aambrose3/ANTERO-Gripper/5B3D-Finger-Model/Circular vs Elliptical Contact Location Error.png

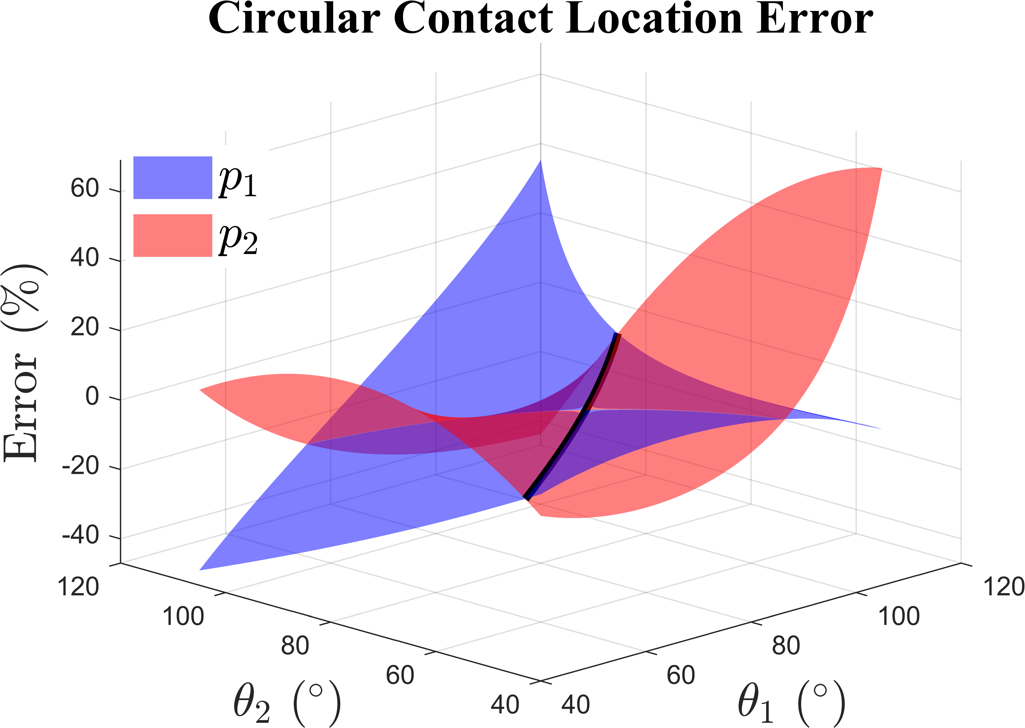
5B3D-Finger-Model/Circular vs Elliptical Contact Location Error.png
