aambrose3/ANTERO-Gripper/5B3D-Finger-Optimization/Feasible-Workspace-Example.png

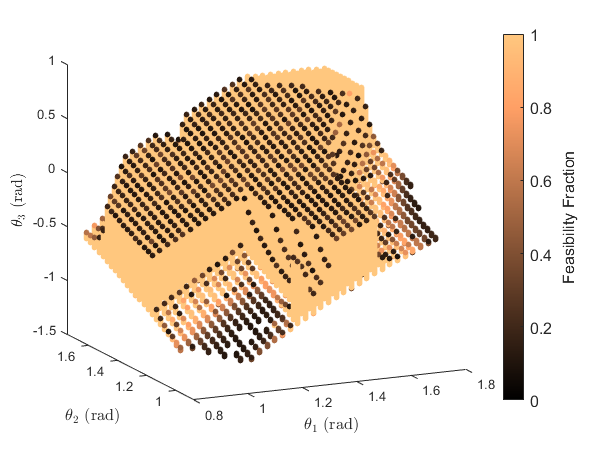
5B3D-Finger-Optimization/Feasible-Workspace-Example.png
