aambrose3/ANTERO-Gripper/5B3D-Spring-Optimization/Simulated_Spring_00236.png

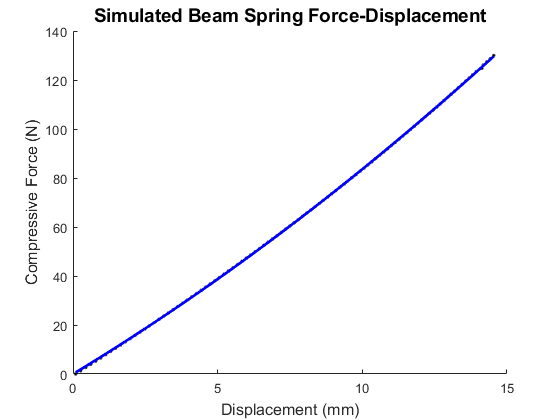
5B3D-Spring-Optimization/Simulated_Spring_00236.png
