aambrose3/ANTERO-Gripper/ANTERO-Mid-Level-Control/PCB Design Files/ANTERO-MidLevel-Control-BOM.pdf

Alex_Teensy4_PCB_BOM_FINAL

Item | Qty (Per Board minimum) | Hyperlink
10 uF Capacitor | | 1 10 uF Cap (https://www.digikey.com/short/b2b8575r)
74LVC2G241DP (3.3V Reg) | | 1 74LVC2G241DP (3.3V Reg) (https://www.digikey.com/short/0vnzmr8h)
AS11AH Switch | | 1 AS11AH Switch (https://mou.sr/4gSaKLc)
JST S3B-EH (Dynamixel Header) | | 1 JST S3B-EH (Dynamixel Header) (https://www.digikey.com/short/1n9ch75f)
LED | | 3 LED (https://www.digikey.com/short/578tjwhb)
Picoblade 1x2 Header | | 1 Picoblade 1x2 Header (https://mou.sr/4hxGuGB)
Picoblade 1x3 Header | | 1 Picoblade 1x3 Header (https://www.digikey.com/short/5mnzjcz0)
Picoblade 1x4 Header | | 2 Picoblade 1x4 Header (https://www.digikey.com/short/jjw4p01n)
Teensy 4.0 | | 1 Teensy 4.0 (https://www.digikey.com/short/fn4n75td)
TLV70233_SOT23-5 | | 1 TLV70233_SOT23-5 (https://www.digikey.com/short/dr4vqt0f)
TS 637 RA Button | | 1 TS 637 RA Button (https://www.digikey.com/short/wfrh9v0z)
TXB0108PWR | | 1 TXB0108PWR (https://www.digikey.com/short/48w32wwn)
Picoblade Wire Crimp | | 12 Picoblade Wire Crimp (https://www.digikey.com/short/d1z87z4w)
1x2 Picoblade Crimp Housing | | 1 1x2 Picoblade Crimp Housing (https://www.digikey.com/short/vjb89p32)
1x3 Picoblade Crimp Housing | | 1 1x3 Picoblade Crimp Housing (https://www.digikey.com/short/pr1hjfqf)
1x4 Picoblade Crimp Housing | | 2 1x4 Picoblade Crimp Housing (https://www.digikey.com/short/mfz52j53)
1x4 Picoblade Crimp Housing | 2
Total

Rec. Qty (5 Boards + Extra) Price Per Unit Price | Digikey/Mouser URLs
10 $1.22 | $12.18 | https://www.digikey.com/short/b2b8575r
10 $0.30 | $2.95 | https://www.digikey.com/short/0vnzmr8h
5 $5.09 | $25.45 | https://mou.sr/4gSaKLc
10 $0.12 | $1.17 | https://www.digikey.com/short/1n9ch75f
18 $0.21 | $3.83 | https://www.digikey.com/short/578tjwhb
10 $0.27 | $2.66 | https://mou.sr/4hxGuGB
10 $0.21 | $2.11 | https://www.digikey.com/short/5mnzjcz0
15 $0.30 | $4.52 | https://www.digikey.com/short/jjw4p01n
5 $27.60 | $138.00 | https://www.digikey.com/short/fn4n75td
10 $0.16 | $1.63 | https://www.digikey.com/short/dr4vqt0f
10 $0.58 | $5.82 | https://www.digikey.com/short/wfrh9v0z
10 $1.03 | $10.28 | https://www.digikey.com/short/48w32wwn
| | https://www.digikey.com/short/d1z87z4w
200 $0.04 | $7.96 | https://www.digikey.com/short/vjb89p32
10 $0.12 | $1.17 | https://www.digikey.com/short/pr1hjfqf
10 $0.14 | $1.36 | https://www.digikey.com/short/mfz52j53
10 $0.16 | $1.61 | https://www.digikey.com/short/mfz52j53
$222.70
