aambrose3/ANTERO-Gripper/ANTERO-Mid-Level-Control/PCB Design Files/ATNERO-PCB/project_library/SnapEDA/TXB0108PWR0.step

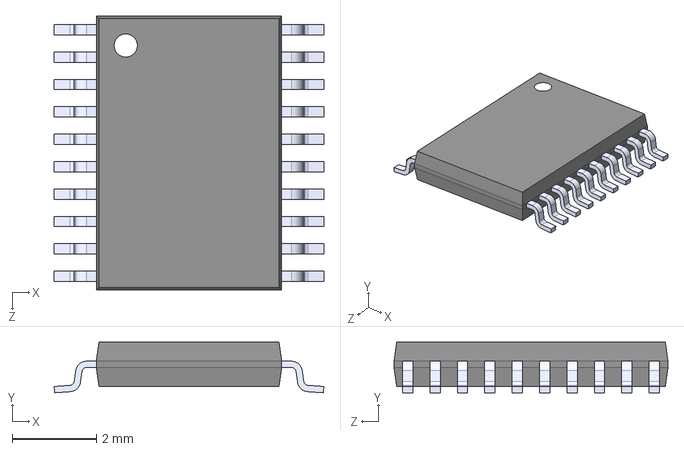
[picture p4: CAD file, 2026-05-11]
ANTERO-Mid-Level-Control/PCB Design Files/ATNERO-PCB/project_library/SnapEDA/TXB0108PWR0.step
6.40 x 1.20 x 6.50 mm
