aambrose3/ANTERO-Gripper/ANTERO-Mid-Level-Control/PCB Design Files/project_library/SnapEDA/74LVC2G241DP,1250.step

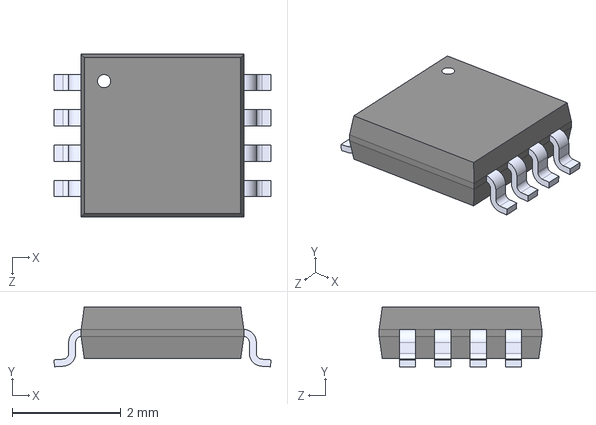
[picture p5: CAD file, 2026-05-11]
ANTERO-Mid-Level-Control/PCB Design Files/project_library/SnapEDA/74LVC2G241DP,1250.step
4.00 x 1.10 x 3.00 mm
