aambrose3/ANTERO-Gripper/ANTERO-Mid-Level-Control/PCB Design Files/ATNERO-PCB/project_library/SnapEDA/ATMEGA2560-16AU0.step

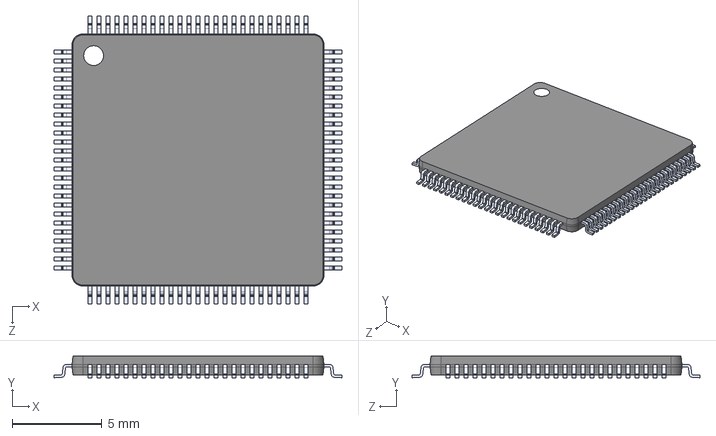
[picture p6: CAD file, 2026-05-11]
ANTERO-Mid-Level-Control/PCB Design Files/ATNERO-PCB/project_library/SnapEDA/ATMEGA2560-16AU0.step
16.0 x 1.20 x 16.0 mm
