aambrose3/ANTERO-Gripper/ANTERO-Mid-Level-Control/PCB Design Files/ATNERO-PCB/project_library/SnapEDA/5304704100.step

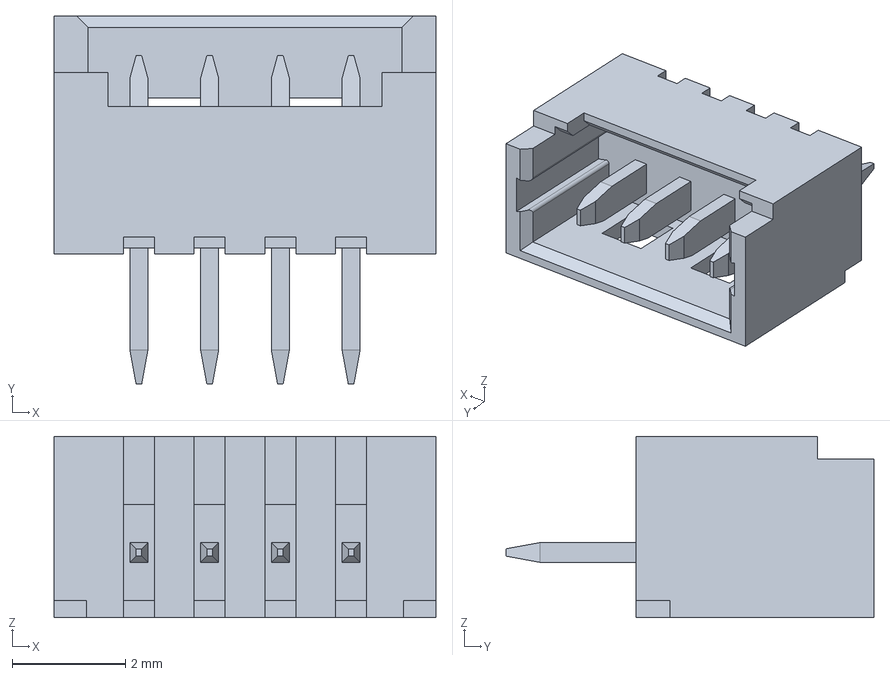
[picture p7: CAD file, 2026-05-11]
ANTERO-Mid-Level-Control/PCB Design Files/ATNERO-PCB/project_library/SnapEDA/5304704100.step
6.75 x 6.50 x 3.20 mm
