aambrose3/ANTERO-Gripper/Grasp-Force-Testing/README.md

There is a specific order you need to run these scripts.

1) Data/unpackTeensyData.m
2) Data/unpackRokubiData.m
3) interpData.m

Then you can run the main file:
4) GraspForceTestingAnalysis.m
