aambrose3/ANTERO-Gripper/5B3D-Finger-Optimization/Results/Feasibility Volume.png

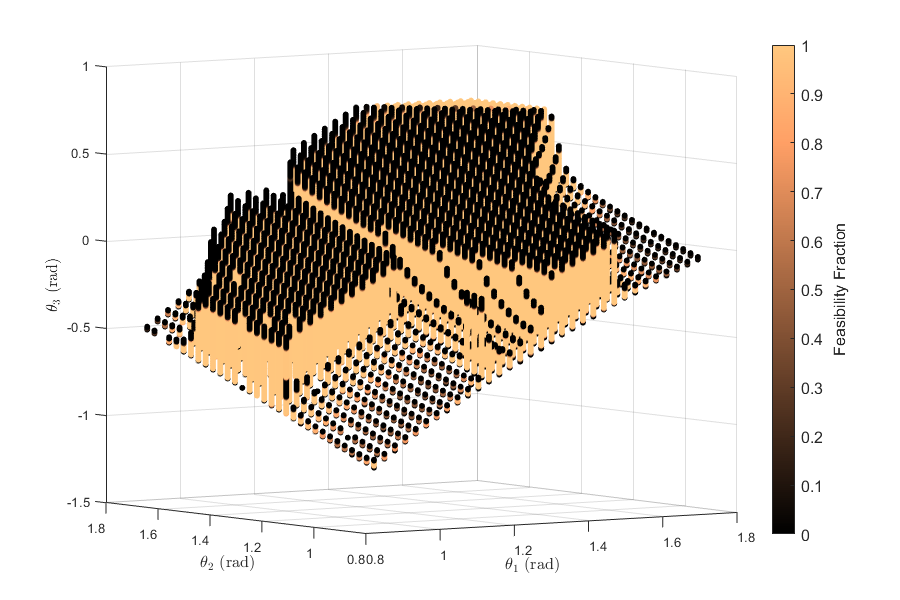
5B3D-Finger-Optimization/Results/Feasibility Volume.png
