aambrose3/ANTERO-Gripper/Grasp-Force-Testing/Example.png

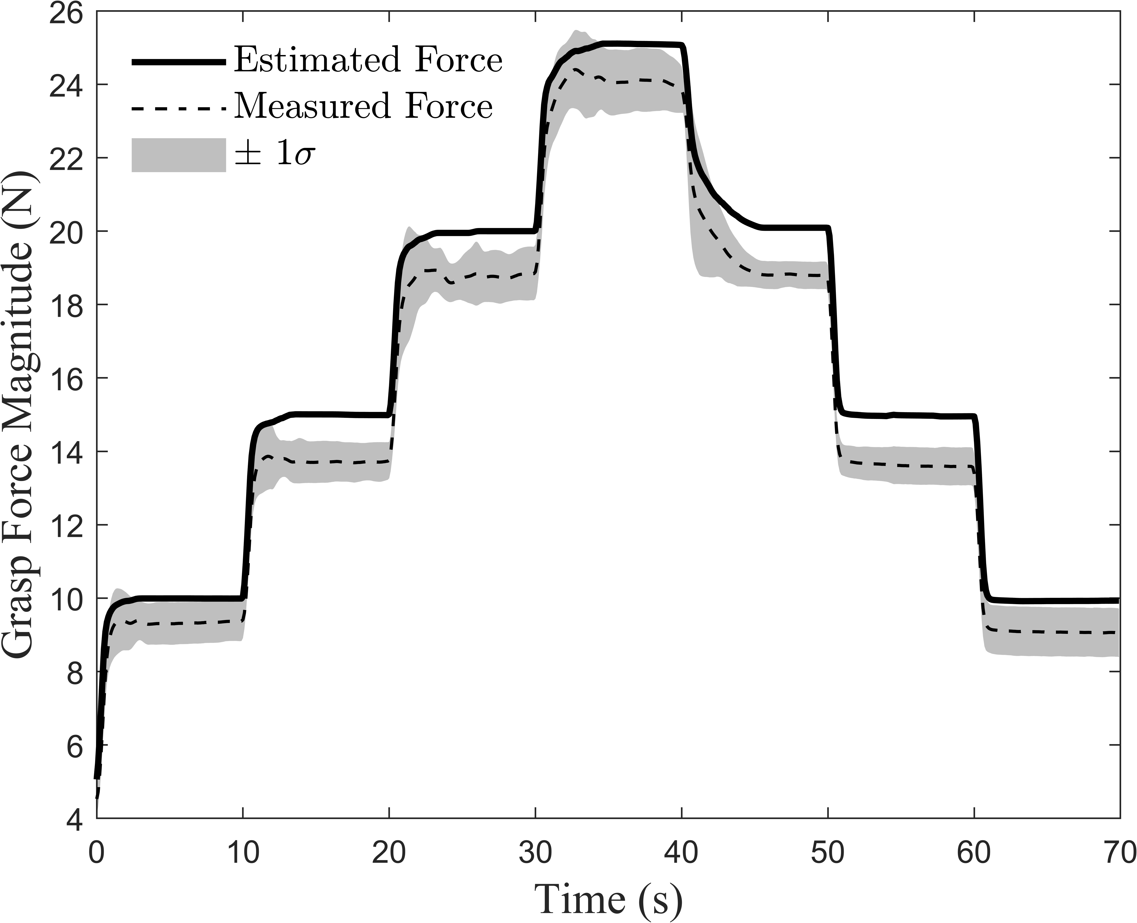
Grasp-Force-Testing/Example.png
