aambrose3/ANTERO-Gripper/Grasp-Force-Testing/Grasp Force Error Overall.png

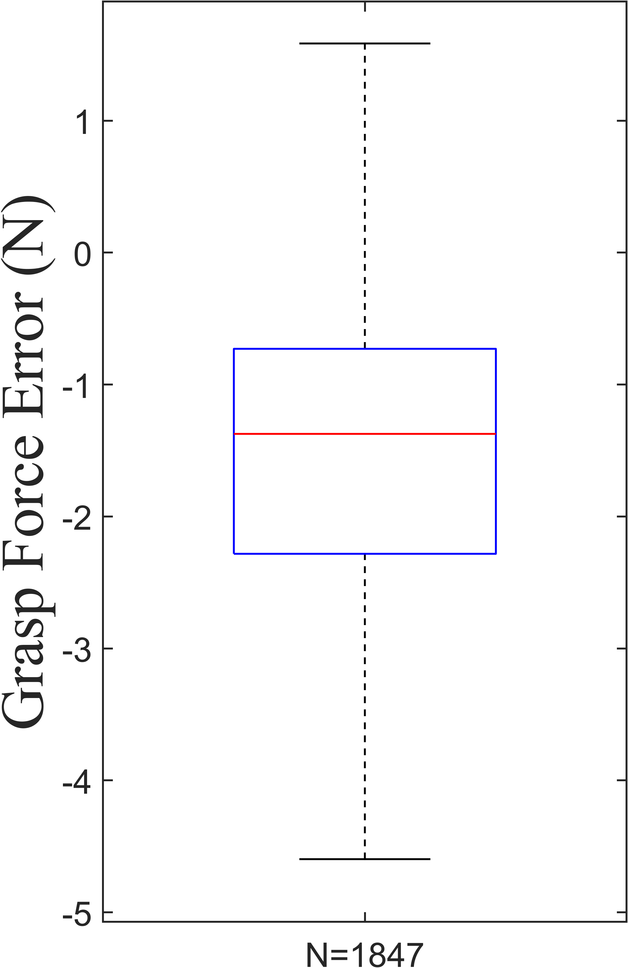
Grasp-Force-Testing/Grasp Force Error Overall.png
