aambrose3/ANTERO-Gripper/Grasp-Force-Testing/Grasp Force Error vs Force.png

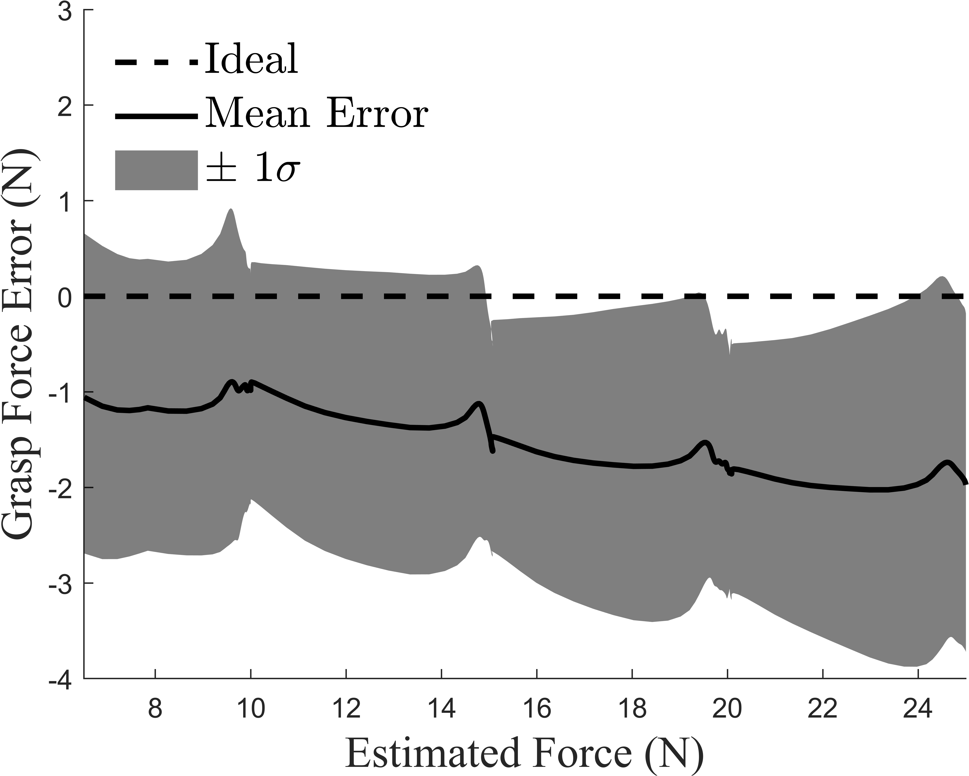
Grasp-Force-Testing/Grasp Force Error vs Force.png
