aambrose3/ANTERO-Gripper/Grasp-Force-Testing/Grasp Force Error vs Object Size.png

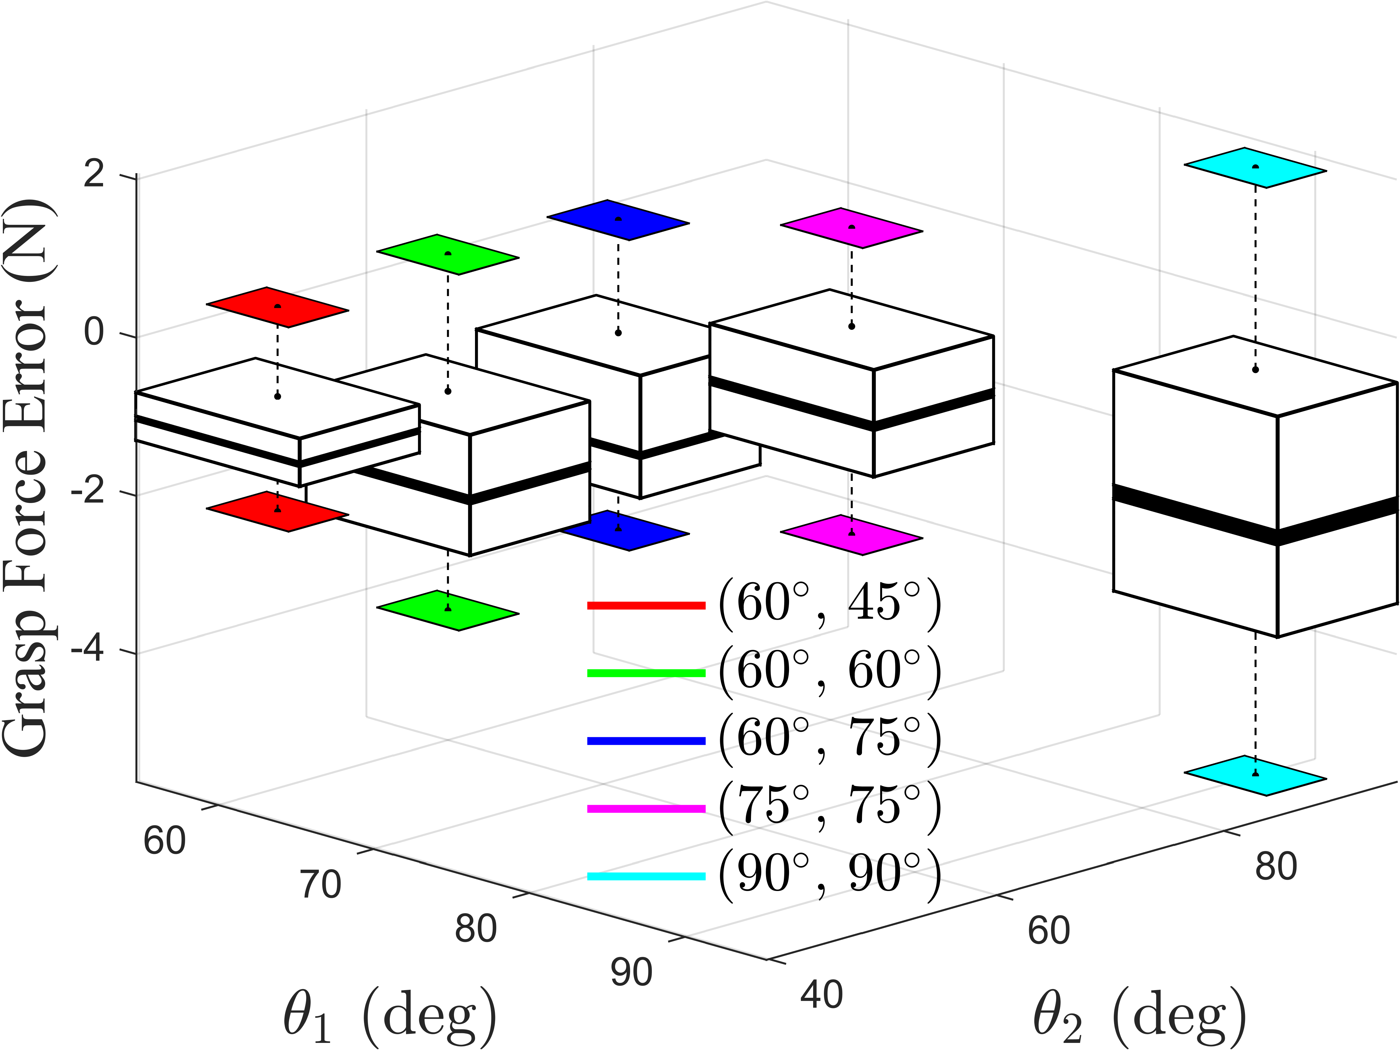
Grasp-Force-Testing/Grasp Force Error vs Object Size.png
