aambrose3/ANTERO-Gripper/ANTERO-Mid-Level-Control/PCB Design Files/ATNERO-PCB/ANTERO-Midlevel-Control.kicad_pcb

## KiCad design ANTERO-Mid-Level-Control/PCB Design Files/ATNERO-PCB/ANTERO-Midlevel-Control.kicad_pcb (2026-05-11)

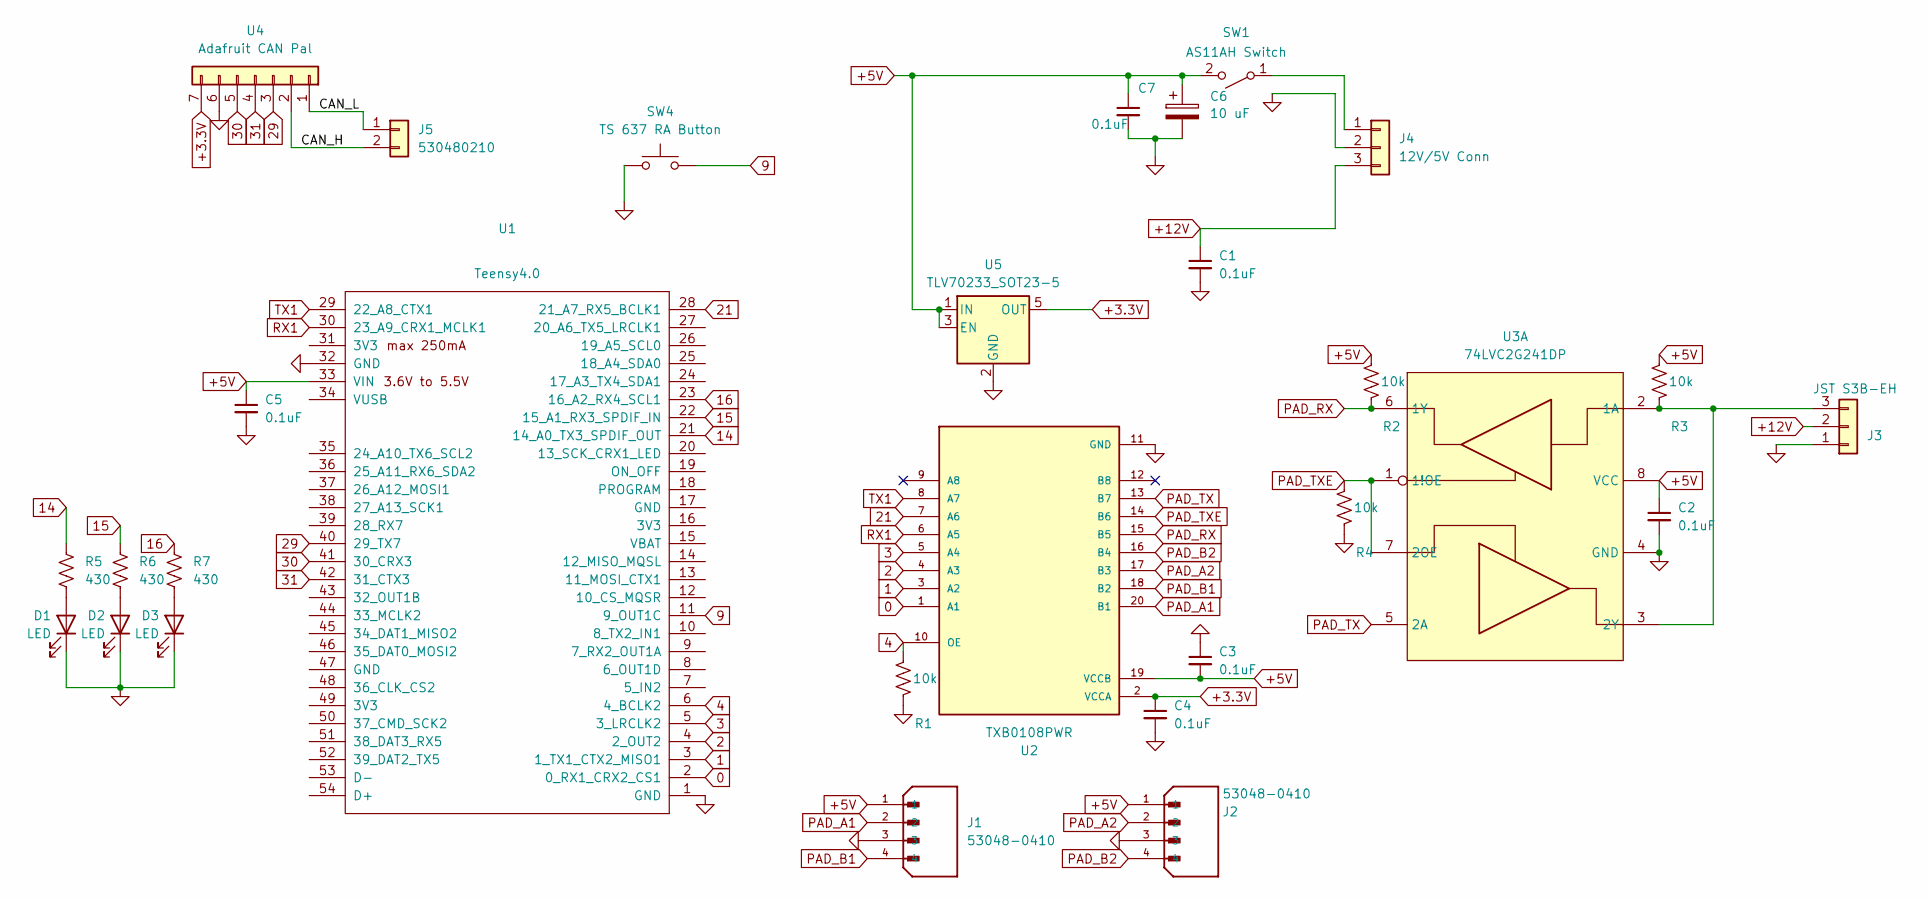
[picture p13: schematic ANTERO-Midlevel-Control.kicad_sch]

Parts:
C1, C2, C3, C4, C5, C7: 0.1uF; C_0805_2012Metric_Pad1.18x1.45mm_HandSolder; Digikey N/A
C6: 10 uF; CP_Elec_5x5.8
D1, D2, D3: LED; LED_0402_1005Metric_Pad0.77x0.64mm_HandSolder
J1, J2: 53048-0410; Molex_PicoBlade_53048-0410_1x04_P1.25mm_Horizontal; PARTREV A
J3: JST S3B-EH; JST_EH_S3B-EH_1x03_P2.50mm_Horizontal
J4: 12V/5V Conn; Molex_PicoBlade_53048-0310_1x03_P1.25mm_Horizontal
J5: 530480210; Molex_PicoBlade_53048-0210_1x02_P1.25mm_Horizontal
R1, R2, R3, R4: 10k; R_0805_2012Metric; Digikey N/A
R5, R6, R7: 430; R_0805_2012Metric; Digikey N/A
SW1: AS11AH Switch; AS1XAH
SW4: TS 637 RA Button; TS-637-RA
U1: Teensy4.0; Teensy40_SMT
U2: TXB0108PWR; SOP65P640X120-20N; PARTREV H
U3: 74LVC2G241DP; TSSOP-8_3x3mm_P0.65mm
U4: Adafruit CAN Pal; Adafruit Can Pal; Digikey N/A
U5: TLV70233_SOT23-5; SOT-23-5

Connections:
0: U1.2 (0_RX1_CRX2_CS1), U2.1 (A1)
1: U1.3 (1_TX1_CTX2_MISO1), U2.3 (A2)
2: U1.4 (2_OUT2), U2.4 (A3)
3: U1.5 (3_LRCLK2), U2.5 (A4)
4: R1.2, U1.6 (4_BCLK2), U2.10 (OE)
9: SW4.2, U1.11 (9_OUT1C)
14: R5.2, U1.21 (14_A0_TX3_SPDIF_OUT)
15: R6.2, U1.22 (15_A1_RX3_SPDIF_IN)
16: R7.2, U1.23 (16_A2_RX4_SCL1)
21: U1.28 (21_A7_RX5_BCLK1), U2.7 (A6)
29: U1.40 (29_TX7), U4.3 (RX)
30: U1.41 (30_CRX3), U4.5 (SLNT)
31: U1.42 (31_CTX3), U4.4 (TX)
+3.3V: C4.1, U2.2 (VCCA), U4.7 (CANL), U5.5 (OUT)
+5V: C2.1, C3.2, C5.1, C6.1, C7.1, J1.1, J2.1, R2.2, R3.2, SW1.2 (B), U1.33 (VIN), U2.19 (VCCB), U3.8 (VCC), U5.1 (IN), U5.3 (EN)
+12V: C1.1, J3.2, J4.3
/CAN_H: J5.2, U4.2 (GND)
/CAN_L: J5.1, U4.1 (Vcc)
GND: C1.2, C2.2, C3.1, C4.2, C5.2, C6.2, C7.2, D1.1 (K), D2.1 (K), D3.1 (K), J1.3, J2.3, J3.1, J4.2, R1.1, R4.1, SW4.1, U1.1 (GND), U1.32 (GND), U2.11 (GND), U3.4 (GND), U4.6 (CANH), U5.2 (GND)
unnamed: D1.2 (A), R5.1
unnamed: D2.2 (A), R6.1
unnamed: D3.2 (A), R7.1
unnamed: J3.3, R3.1, U3.2 (1A), U3.3 (2Y)
unnamed: J4.1, SW1.1 (A)
PAD_A1: J1.2, U2.20 (B1)
PAD_A2: J2.2, U2.17 (B3)
PAD_B1: J1.4, U2.18 (B2)
PAD_B2: J2.4, U2.16 (B4)
PAD_RX: R2.1, U2.15 (B5), U3.6 (1Y)
PAD_TX: U2.13 (B7), U3.5 (2A)
PAD_TXE: R4.2, U2.14 (B6), U3.1 (1!OE), U3.7 (2OE)
RX1: U1.30 (23_A9_CRX1_MCLK1), U2.6 (A5)
TX1: U1.29 (22_A8_CTX1), U2.8 (A7)

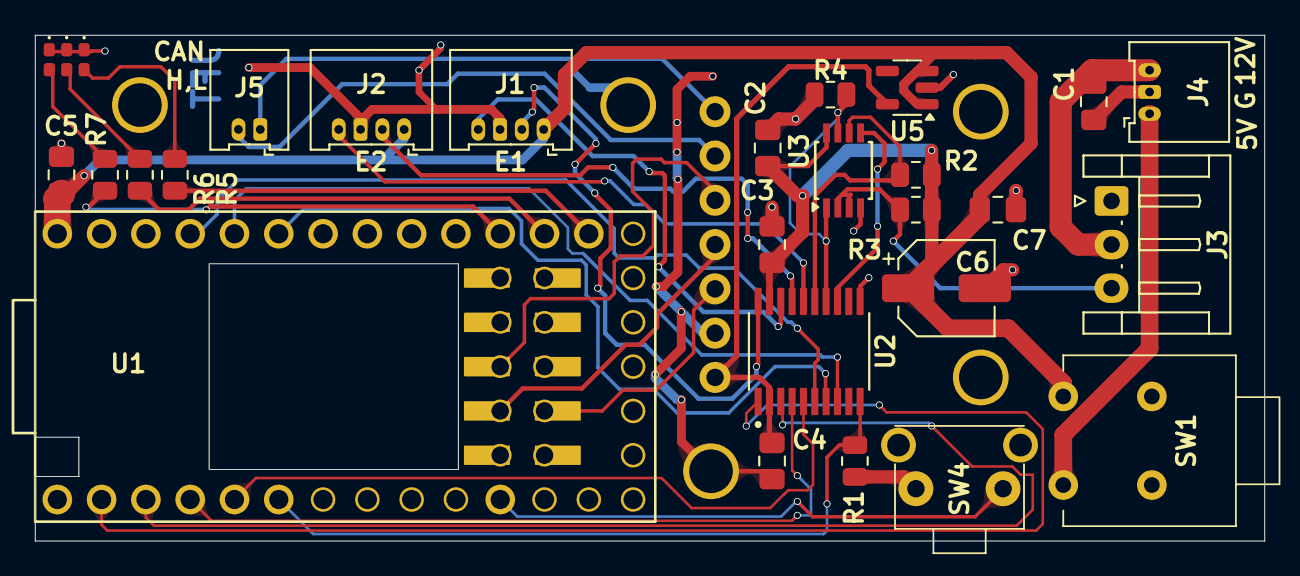
[picture p14: board ANTERO-Mid-Level-Control/PCB Design Files/ATNERO-PCB/ANTERO-Midlevel-… from above]

Board: 2 copper layers, 70.5 x 29.0 mm, 29 parts (1 on the bottom side), 33 nets.
