aambrose3/ANTERO-Gripper/ANTERO-Mid-Level-Control/PCB Design Files/ANTERO-Midlevel-Control.kicad_pcb

## KiCad design ANTERO-Mid-Level-Control/PCB Design Files/ANTERO-Midlevel-Control.kicad_pcb (2026-05-11)

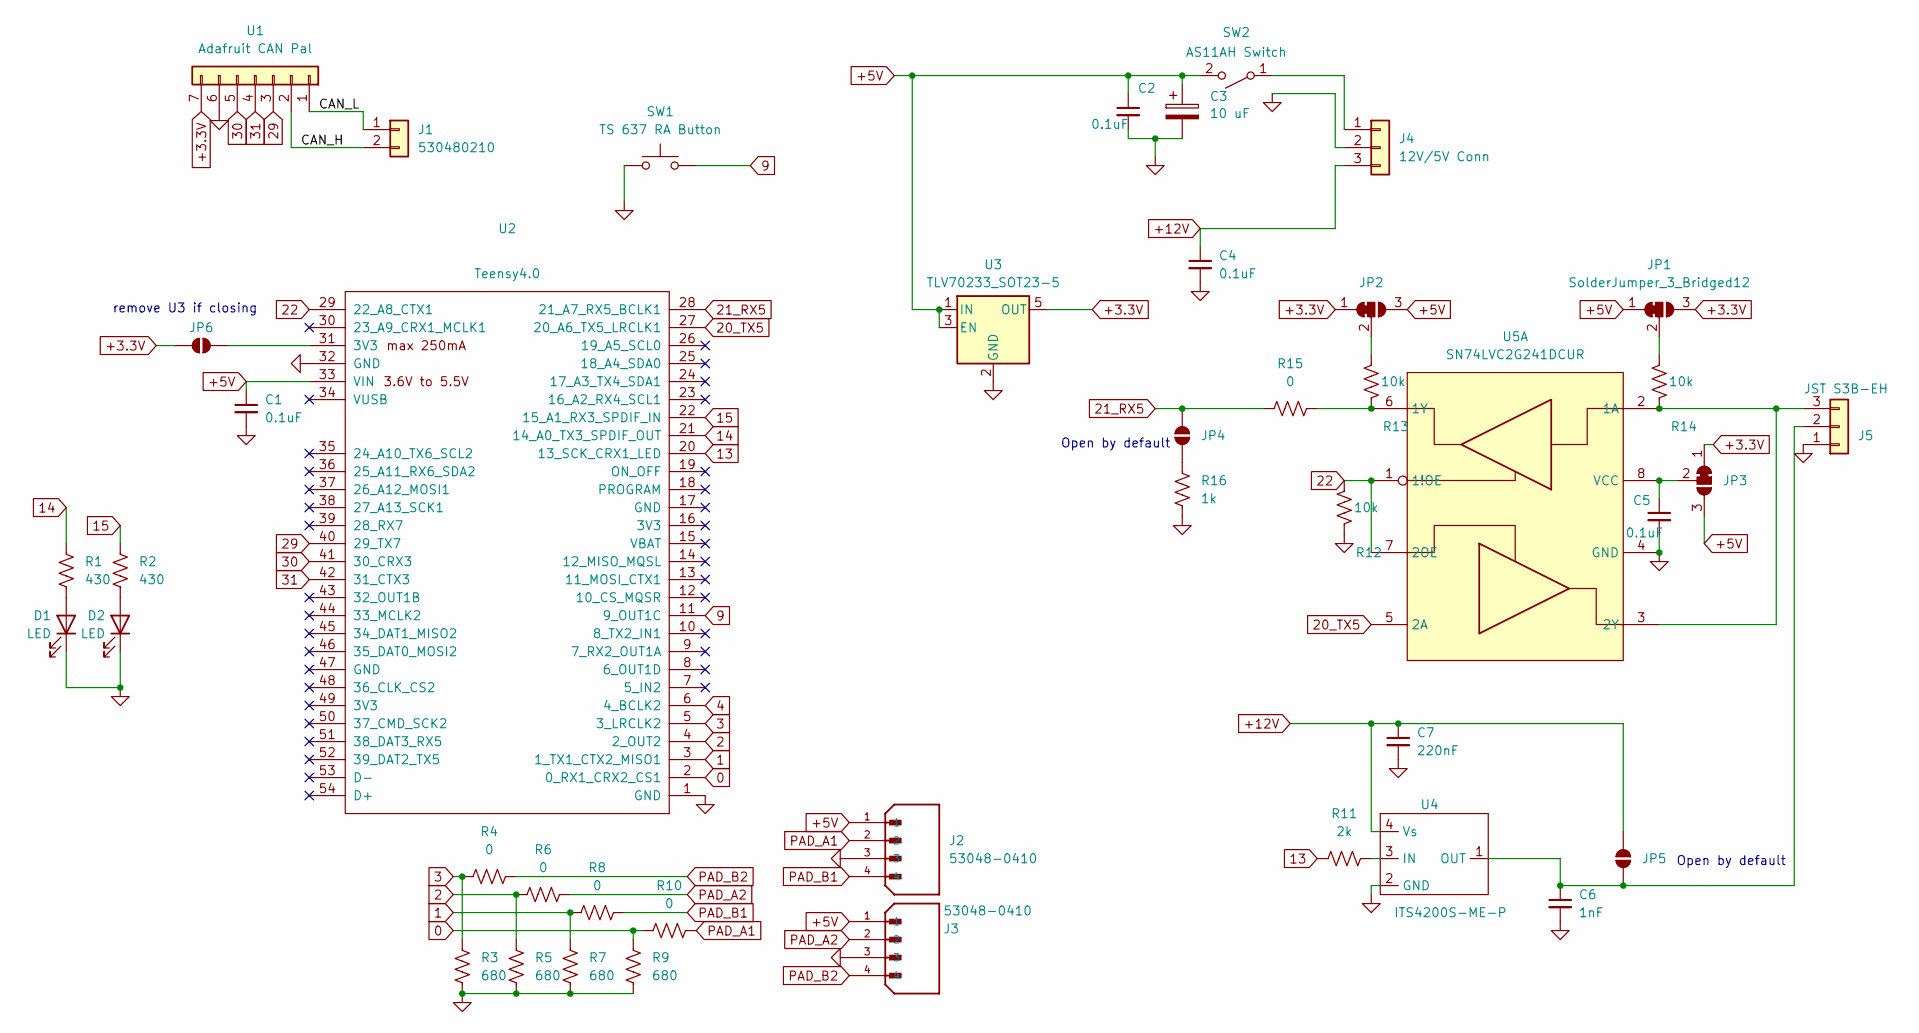
[picture p15: schematic ANTERO-Midlevel-Control.kicad_sch, AlexTeensy4PCBv3]

Parts:
C1, C2, C4, C5: 0.1uF; C_0805_2012Metric_Pad1.18x1.45mm_HandSolder; Digikey N/A
C3: 10 uF; CP_Elec_5x5.8
C6: 1nF; C_0805_2012Metric_Pad1.18x1.45mm_HandSolder; Digikey N/A
C7: 220nF; C_0805_2012Metric_Pad1.18x1.45mm_HandSolder; Digikey N/A
D1, D2: LED; LED_0402_1005Metric_Pad0.77x0.64mm_HandSolder
J1: 530480210; Molex_PicoBlade_53048-0210_1x02_P1.25mm_Horizontal
J2, J3: 53048-0410; Molex_PicoBlade_53048-0410_1x04_P1.25mm_Horizontal; PARTREV A
J4: 12V/5V Conn; Molex_PicoBlade_53048-0310_1x03_P1.25mm_Horizontal
J5: JST S3B-EH; JST_EH_S3B-EH_1x03_P2.50mm_Horizontal
JP1, JP2, JP3: SolderJumper_3_Bridged12; SolderJumper-3_P1.3mm_Bridged12_RoundedPad1.0x1.5mm_NumberL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
JP4: SolderJumper_2_Open; SolderJumper-2_P1.3mm_Open_Pad1.0x1.5mm_SMALLER
JP5, JP6: SolderJumper_2_Open; SolderJumper-2_P1.3mm_Open_RoundedPad1.0x1.5mm
R1, R2: 430; R_0805_2012Metric; Digikey N/A
R3, R5, R7, R9: 680; R_0805_2012Metric; Digikey N/A
R4, R6, R8, R10, R15: 0; R_0805_2012Metric; Digikey N/A
R11: 2k; R_0805_2012Metric; Digikey N/A
R12, R13, R14: 10k; R_0805_2012Metric; Digikey N/A
R16: 1k; R_0805_2012Metric; Digikey N/A
SW1: TS 637 RA Button; TS-637-RA
SW2: AS11AH Switch; AS1XAH
U1: Adafruit CAN Pal; Adafruit Can Pal; Digikey N/A
U2: Teensy4.0; Teensy40_SMT
U3: TLV70233_SOT23-5; SOT-23-5
U4: ITS4200S-ME-P; SOT-223
U5: SN74LVC2G241DCUR; VSSOP-8_2.3x2mm_P0.5mm

Connections:
0: R9.2, R10.1, U2.2 (0_RX1_CRX2_CS1)
1: R7.2, R8.1, U2.3 (1_TX1_CTX2_MISO1)
2: R5.2, R6.1, U2.4 (2_OUT2)
3: R3.2, R4.1, U2.5 (3_LRCLK2)
4: U2.6 (4_BCLK2)
9: SW1.2, U2.11 (9_OUT1C)
13: R11.1, U2.20 (13_SCK_CRX1_LED)
14: R1.2, U2.21 (14_A0_TX3_SPDIF_OUT)
15: R2.2, U2.22 (15_A1_RX3_SPDIF_IN)
20_TX5: U2.27 (20_A6_TX5_LRCLK1), U5.5 (2A)
21_RX5: JP4.2 (B), R15.1, U2.28 (21_A7_RX5_BCLK1)
22: R12.2, U2.29 (22_A8_CTX1), U5.1 (1!OE), U5.7 (2OE)
29: U1.3 (RX), U2.40 (29_TX7)
30: U1.5 (SLNT), U2.41 (30_CRX3)
31: U1.4 (TX), U2.42 (31_CTX3)
+3.3V: JP1.3 (B), JP2.1 (A), JP3.1 (A), JP6.2 (B), U1.7 (CANL), U3.5 (OUT)
+5V: C1.1, C2.1, C3.1, J2.1, J3.1, JP1.1 (A), JP2.3 (B), JP3.3 (B), SW2.2 (B), U2.33 (VIN), U3.1 (IN), U3.3 (EN)
+12V: C4.1, C7.1, J4.3, JP5.2 (B), U4.4 (Vs)
/CAN_H: J1.2, U1.2 (GND)
/CAN_L: J1.1, U1.1 (Vcc)
GND: C1.2, C2.2, C3.2, C4.2, C5.2, C6.2, C7.2, D1.1 (K), D2.1 (K), J2.3, J3.3, J4.2, J5.1, R3.1, R5.1, R7.1, R9.1, R12.1, R16.1, SW1.1, U1.6 (CANH), U2.1 (GND), U2.32 (GND), U3.2 (GND), U4.2 (GND), U5.4 (GND)
unnamed: D1.2 (A), R1.1
unnamed: D2.2 (A), R2.1
unnamed: J4.1, SW2.1 (A)
unnamed: C6.1, J5.2, JP5.1 (A), U4.1 (OUT)
unnamed: J5.3, R14.1, U5.2 (1A), U5.3 (2Y)
unnamed: JP1.2 (C), R14.2
unnamed: JP2.2 (C), R13.2
unnamed: C5.1, JP3.2 (C), U5.8 (VCC)
unnamed: JP4.1 (A), R16.2
unnamed: JP6.1 (A), U2.31 (3V3)
unnamed: R11.2, U4.3 (IN)
unnamed: R13.1, R15.2, U5.6 (1Y)
PAD_A1: J2.2, R10.2
PAD_A2: J3.2, R6.2
PAD_B1: J2.4, R8.2
PAD_B2: J3.4, R4.2

Notes on the sheet:
Open by default
remove U3 if closing

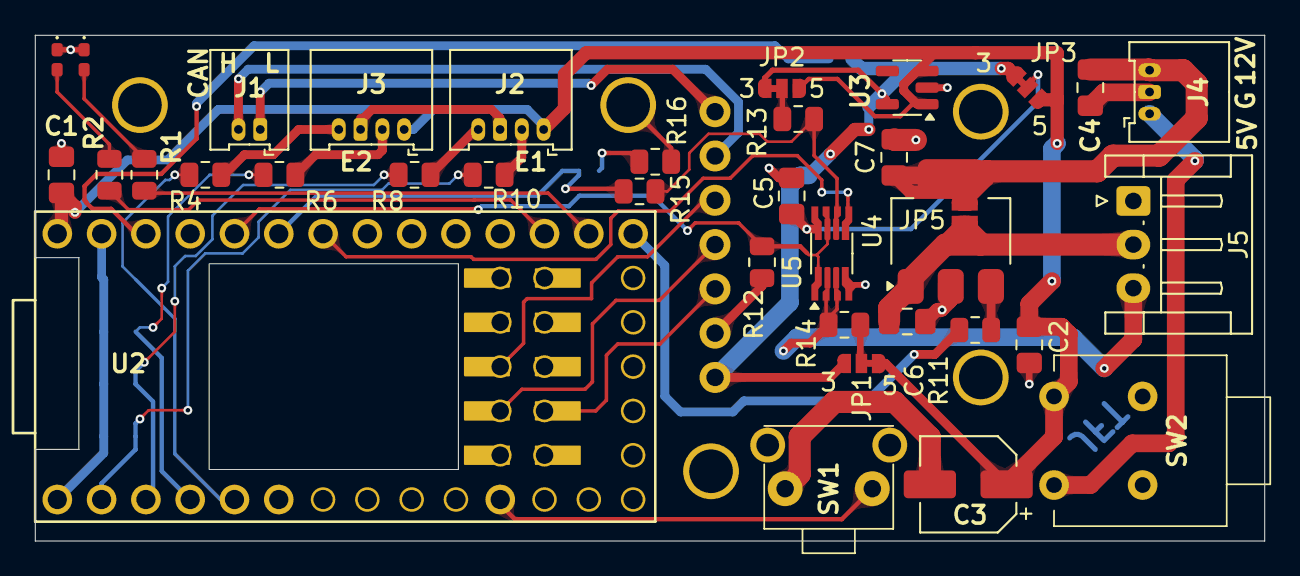
[picture p16: board ANTERO-Mid-Level-Control/PCB Design Files/ANTERO-Midlevel-Control.kic… from above]

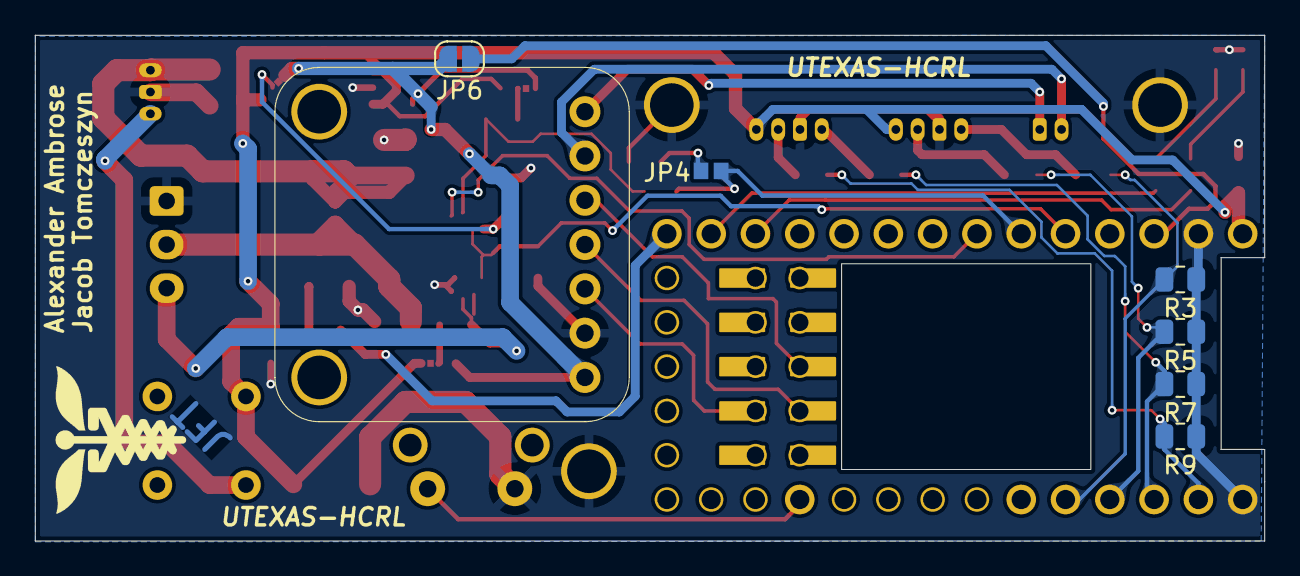
[picture p17: board ANTERO-Mid-Level-Control/PCB Design Files/ANTERO-Midlevel-Control.kic… from below]

Board: 2 copper layers, 70.5 x 29.0 mm, 43 parts (7 on the bottom side), 36 nets.
